NazmulTakbir/CSE-316-Project-/README.md

### CSE 316 Project 
# A Smart Stick for Blind People  with object detection and direction guidance
We developed this project for our CSE 316 course on Microprocessors, Microcontrollers and Embedded Systems

Our project was supervised by [Md. Tareq Mahmood](https://sites.google.com/view/mdtareqmahmood/) - Lecturer at Department of CSE, BUET
___
### Related Resources :
[Project Report](https://github.com/NazmulTakbir/CSE-316-Project-/blob/main/Project%20Report.pdf)

[Code for the Android App](https://github.com/ksaifahmed/the_stick_app)

### Video Demonstration :
Click [here](https://youtu.be/c8J_XOOHVkg) to see the video on YouTube.

### Contributors :

| Name | Email |
| --- | --- |
| [Nazmul Takbir](https://nazmultakbir.github.io/) | takbir.nazmul@gmail.com |
| [Saif Ahmed Khan](https://github.com/ksaifahmed) | ksaifahmed4@gmail.com |
| [Sihat Afnan](https://github.com/AfnanCSE98) | sihatafnan15.9.1997@gmail.com |
